bit7io/mineapple/README.md

# mineapple

A project to design an open source, modular mining system based around the ASICs reverse engineered by the [bitaxe](https://bitaxe.org/) project and [OSMU](https://www.opensourceminers.org/) community.
