bit7io/mineapple/hardware/prototypes/core-2xpcie-daisy/README.md

# Prototype chainable PCIe Core
Known issues:
- Straddle mount PCIe connector misaligned

Changes for V1.0:
- Move power monitoring from Scales to Core boards
