bit7io/mineapple/hardware/prototypes/scale-tps40303-bm1397/README.md

# Prototype BM1397 Scale
Known issues:
- M1 footprint incorrect
- R10 part number/footprint incorrect
- J1/J2 - TagConnect connector was used instead of SKEDD

Changes for V1.0:
- Fix known issues
- Move power monitoring to Core boards
- Remove 4V0 input
- Balance number of VPWR/PGND pins
