bit7io/mineapple/hardware/prototypes/scale-tps40303-bm1397/source/mineapple-scale.kicad_pcb

## KiCad design hardware/prototypes/scale-tps40303-bm1397/source/mineapple-scale.kicad_pcb (2024-01-18)

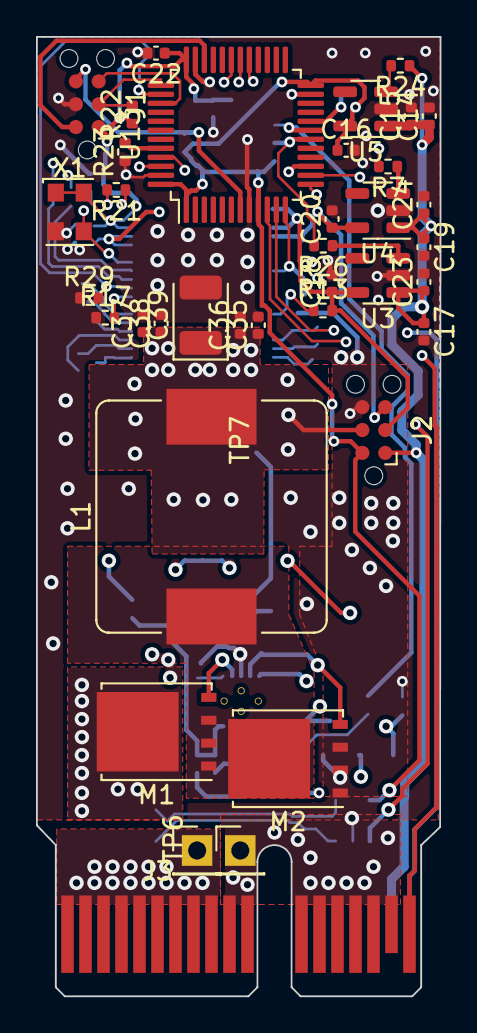
[picture p12: board mineapple-scale.kicad_pcb from above]

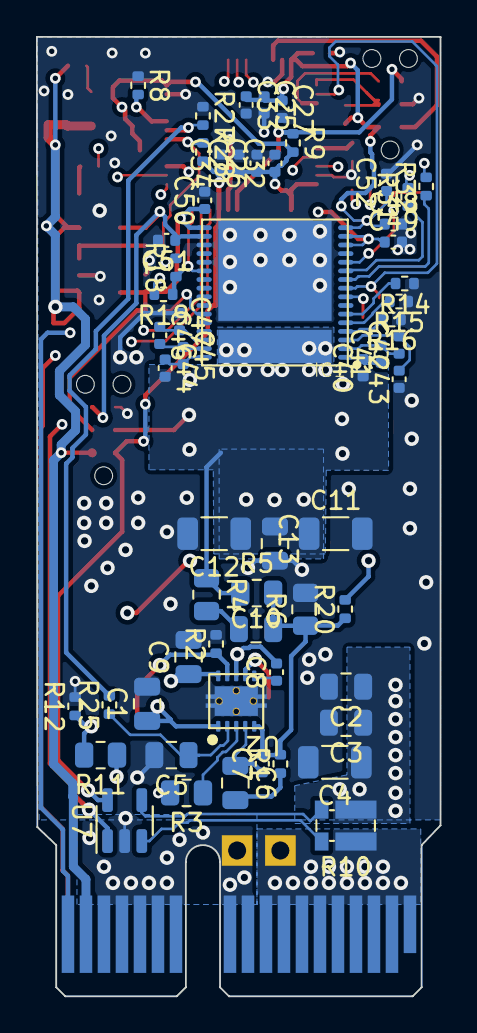
[picture p13: board mineapple-scale.kicad_pcb from below]

Board: 4 copper layers, 22.4 x 53.3 mm, 95 parts (58 on the bottom side), 58 nets.

Parts:
C1: 1uF; C_0805_2012Metric
C2, C3: 22uF; C_0805_2012Metric
C4: 47uF; C_1206_3216Metric
C5: 3.3nF; C_0805_2012Metric
C6: 11nF; C_0805_2012Metric
C7: 470pF; C_0402_1005Metric
C8, C22, C32, C33, C34: 100nF; C_0402_1005Metric
C9: 10uF; C_0805_2012Metric
C10: 3.9nF; C_0805_2012Metric
C11, C12: 220uF; C_1206_3216Metric
C13: 100uF; C_0805_2012Metric
C14, C16, C18, C20, C21, C23, C24, C27, C35, C37, C40, C41, C42, C43, C44, C45, C46, C47, C48, C49, C50, C51: 1uF; C_0402_1005Metric
C15, C17, C19, C36, C38, C52: 0.1uF; C_0402_1005Metric
C25: 10nF; C_0402_1005Metric
C26: 4.7uF; C_0402_1005Metric
C39: 330uF; CP_EIA-3528-21_Kemet-B
IC1: BM1397_mode1; BM1397
J1, J2: Conn_SKEDD_6pos; Tag-Connect_TC2030-IDC-NL_2x03_P1.27mm_Vertical
J3: MAS_Edge_Connector; BUS_PCIexpress_x1
L1: 1.3uH; L_Bourns_SRP1245A
M1: CSD17304Q3; TDSON-8-1
M2: CSD17573Q5B; TDSON-8-1
R1: 3.83k; R_0402_1005Metric
R2: 1.74k; R_0402_1005Metric
R3, R11: 100k; R_0805_2012Metric
R4: 432; R_0805_2012Metric
R5: 10k; R_0805_2012Metric
R6: 6.65k; R_0805_2012Metric
R7, R18, R20, R21, R25, R26, R31, R32: 1k; R_0402_1005Metric
R8, R9, R12, R13, R14, R15, R16, R17, R22, R23, R24, R27, R28, R29: 15k; R_0402_1005Metric
R10: 2mOhm; R_Shunt_Vishay_WSKW0612
R19: 2k; R_0402_1005Metric
TP6, TP7: TestPoint; PinHeader_1x01_P2.54mm_Vertical
U2: TPS40303DRCR; TPS40305
U3: MIC5504-1.8YM5; SOT-23-5
U4: TPS7A0508PDBV; SOT-23-5
U5: MIC5504-3.3YM5; SOT-23-5
U7: INA180A4; SOT-23-5
U13: STM32F072CBTx; LQFP-48_7x7mm_P0.5mm
X1: 25MHz; Oscillator_SMD_EuroQuartz_XO32-4Pin_3.2x2.5mm

Connections:
0V8: C20.1, C49.1, C51.1, IC1.14 (PLL_VDD), IC1.15 (VDDIO_08_0), IC1.18 (VDDIO_08_1), J2.5, U4.5 (OUT)
1V5: C11.1, C12.1, C13.1, C35.1, C36.1, C37.1, C38.1, C39.1, C40.1, C44.2, IC1.33 (VDD), J2.4, L1.2, R4.1, R5.1
1V8: C18.1, C22.1, C25.1, C27.1, C33.1, C48.1, C50.1, C52.1, IC1.16 (VDDIO_18_0), IC1.17 (VDDIO_18_1), J1.1, J2.3, R13.2, R22.1, U3.5 (VOUT), U13.36 (VDDIO2), X1.1 (EN), X1.4 (V+)
3V3: C16.1, C21.1, C26.1, C32.1, C34.1, J2.2, R9.2, R28.2, U5.5 (VOUT), U7.5 (V+), U13.1 (VBAT), U13.9 (VDDA), U13.24 (VDD), U13.48 (VDD)
4V0: C14.1, C15.1, C17.1, C19.1, C23.1, C24.1, J2.1, J3.A17 (4V0), R24.1, U3.1 (VIN), U4.1 (IN), U5.1 (VIN)
/MCU/SWDCLK: J1.3, R22.2, U13.37 (PA14)
/MCU/SWDIO: J1.2, U13.34 (PA13)
ADC12_IN0: U7.1, U13.10 (PA0)
ADC12_IN1: R11.2, R12.1, U13.11 (PA1)
CAN_RX: J3.A18 (CAN_RX), U13.45 (PB8)
CAN_TX: J3.B18 (CAN_TX), U13.46 (PB9)
EN0V8: R7.2, R8.2, U13.20 (PB2)
EN1V5: R25.2, R27.2, U13.19 (PB1)
EN1V8: R26.2, R28.1, U13.18 (PB0)
FB1V5: R20.2, U13.15 (PA5)
GND: C1.2, C2.2, C3.2, C4.2, C5.2, C9.2, C11.2, C12.2, C13.2, C14.2, C15.2, C16.2, C17.2, C18.2, C19.2, C20.2, C21.2, C22.2, C23.2, C24.2, C25.2, C26.2, C27.2, C32.2, C33.2, C34.2, C35.2, C36.2, C37.2, C38.2, C39.2, C43.1, C47.1, C48.2, C49.2, C50.2, C51.2, C52.2, IC1.13 (PLL_VSS), IC1.19 (VSS), IC1.21 (TEMP_N), IC1.34 (VSS_0), J1.4, J2.6, J3.A10 (PGND), J3.A11 (PGND), J3.A12 (PGND), J3.A13 (PGND), J3.A14 (PGND), J3.A15 (PGND), J3.A16 (PGND), J3.B10 (PGND), J3.B11 (PGND), J3.B12 (PGND), J3.B13 (PGND), J3.B14 (PGND), J3.B15 (PGND), J3.B16 (PGND), J3.B17 (PGND), M2.1 (S), M2.2 (S), M2.3 (S), R2.2, R6.2, R8.1, R12.2, R14.1, R15.1, R16.1, R17.1, R23.1, R27.1, R29.1, TP7.1, U2.11 (GND), U3.2 (GND), U4.2 (GND), U5.2 (GND), U7.2 (GND), U13.8 (VSSA), U13.23 (VSS), U13.35 (VSS), U13.47 (VSS), X1.2 (GND)
unnamed: C6.2, R1.1
unnamed: C10.1, R4.2
unnamed: IC1.4 (ADDR0), R16.2
unnamed: IC1.5 (ADDR1), R15.2
unnamed: IC1.6 (ADDR2), R14.2
unnamed: IC1.8 (BI), R17.2
unnamed: IC1.12 (CLKI), R21.2, X1.3 (OUT)
unnamed: IC1.27 (RI), R13.1
unnamed: C42.2, C43.2, IC1.3 (VDD1_0)
unnamed: C46.1, C47.2, IC1.30 (VDD1_1)
unnamed: C41.2, C42.1, IC1.2 (VDD2_0)
unnamed: C45.1, C46.2, IC1.31 (VDD2_1)
unnamed: C40.2, C41.1, IC1.1 (VDD3_0)
unnamed: C44.1, C45.2, IC1.32 (VDD3_1)
unnamed: C1.1, C2.1, C3.1, C4.1, M1.5 (D), R10.4, U2.1 (VDD)
unnamed: M1.4 (G), U2.7 (HDRV)
unnamed: C8.2, L1.1, M1.1 (S), M1.2 (S), M1.3 (S), M2.5 (D), U2.8 (SW)
unnamed: M2.4 (G), R2.1, U2.9 (LDRV/OC)
unnamed: C8.1, U2.6 (BOOT)
unnamed: C9.1, R3.2, U2.10 (BP)
unnamed: C6.1, C7.1, U2.4 (COMP)
unnamed: C5.1, R25.1, U2.2 (EN/SS)
unnamed: C7.2, C10.2, R1.2, R5.2, R6.1, R20.1, U2.5 (FB)
unnamed: R3.1, U2.3 (PGOOD)
unnamed: R26.1, U3.3 (EN)
unnamed: R7.1, U4.3 (EN)
unnamed: R24.2, U5.3 (EN)
unnamed: R10.2, U7.3 (+)
unnamed: R10.3, U7.4 (-)
unnamed: R23.2, U13.44 (BOOT0)
unnamed: R18.2, U13.13 (PA3)
unnamed: R19.2, U13.14 (PA4)
unnamed: R31.2, U13.30 (PA9)
unnamed: R32.2, U13.31 (PA10)
SWO: J1.5, U13.39 (PB3)
TEMP_P: IC1.22 (TEMP_P), R18.1, R19.1, U13.12 (PA2)
UCLK: R21.1, U13.29 (PA8)
URST: IC1.9 (NRSTI), R29.2, U13.38 (PA15)
URXD: IC1.10 (RO), R32.1
UTXD: IC1.11 (CI), R31.1
VPWR: J3.A1 (VPWR), J3.A2 (VPWR), J3.A3 (VPWR), J3.A4 (VPWR), J3.A5 (VPWR), J3.A6 (VPWR), J3.A7 (VPWR), J3.A8 (VPWR), J3.A9 (VPWR), J3.B1 (VPWR), J3.B2 (VPWR), J3.B3 (VPWR), J3.B4 (VPWR), J3.B5 (VPWR), J3.B6 (VPWR), J3.B7 (VPWR), J3.B8 (VPWR), J3.B9 (VPWR), R10.1, R11.1, TP6.1
nRESET: J1.6, R9.1, U13.7 (NRST)
